ATHARM4/SpO2-Project/Presentation.pdf

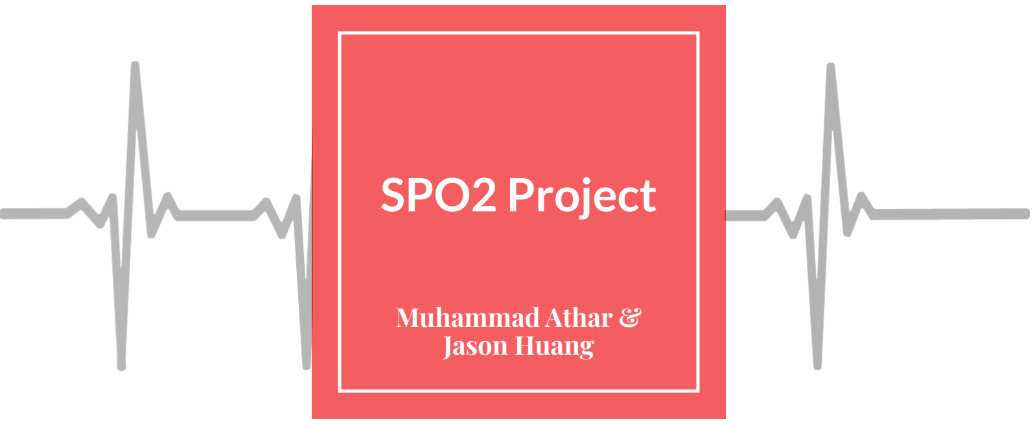
[picture p18: page 1]

## SPO2 Project

Muhammad Athar &
Jason Huang

## Brief Overview

❏ Requirements and Constraints ❏ High Level Model
❏ Individual Subcircuits
❏ Arduino
❏ Validation

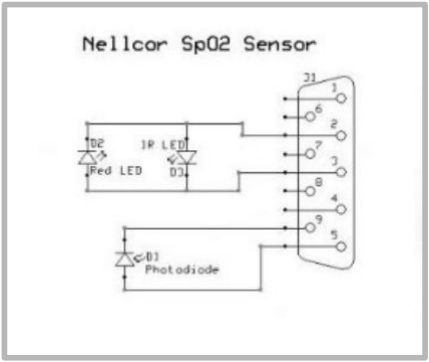
[picture p19: figure]

SpO2 Sensor Pinout

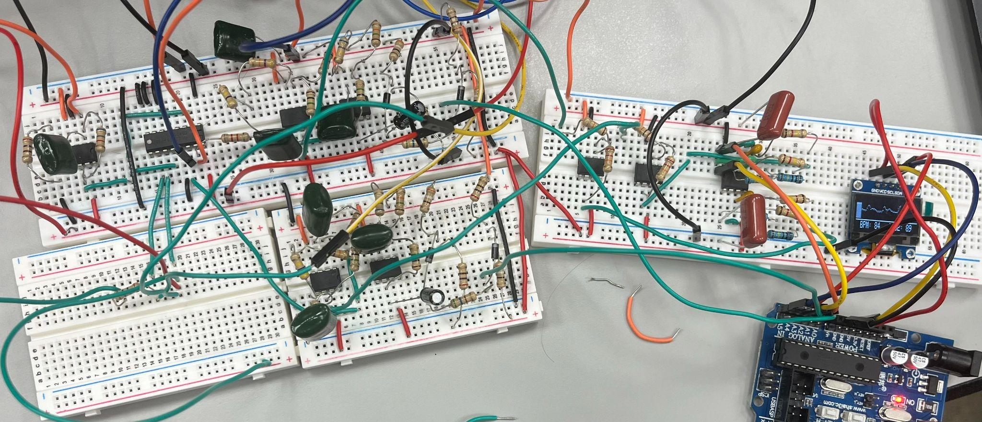
[picture p20: figure]

Final Working Product

## Design Requirements & Constraints

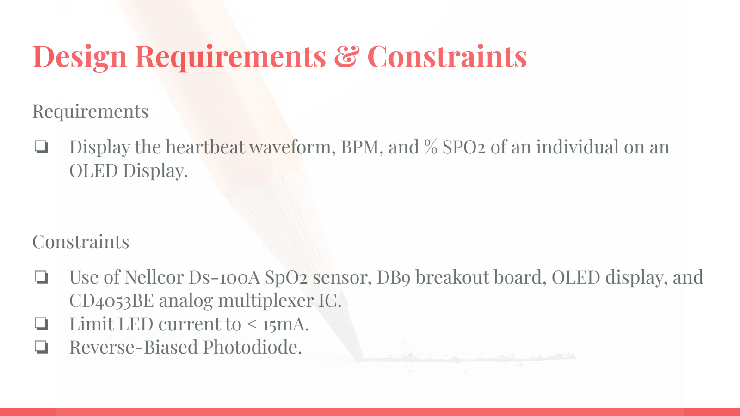
[picture p21: page 3]

Requirements
❏ Display the heartbeat waveform, BPM, and % SPO2 of an individual on an OLED Display.

Constraints
❏ Use of Nellcor Ds-100A SpO2 sensor, DB9 breakout board, OLED display, and CD4053BE analog multiplexer IC.
❏ Limit LED current to < 15mA.
❏ Reverse-Biased Photodiode.

## High Level Model

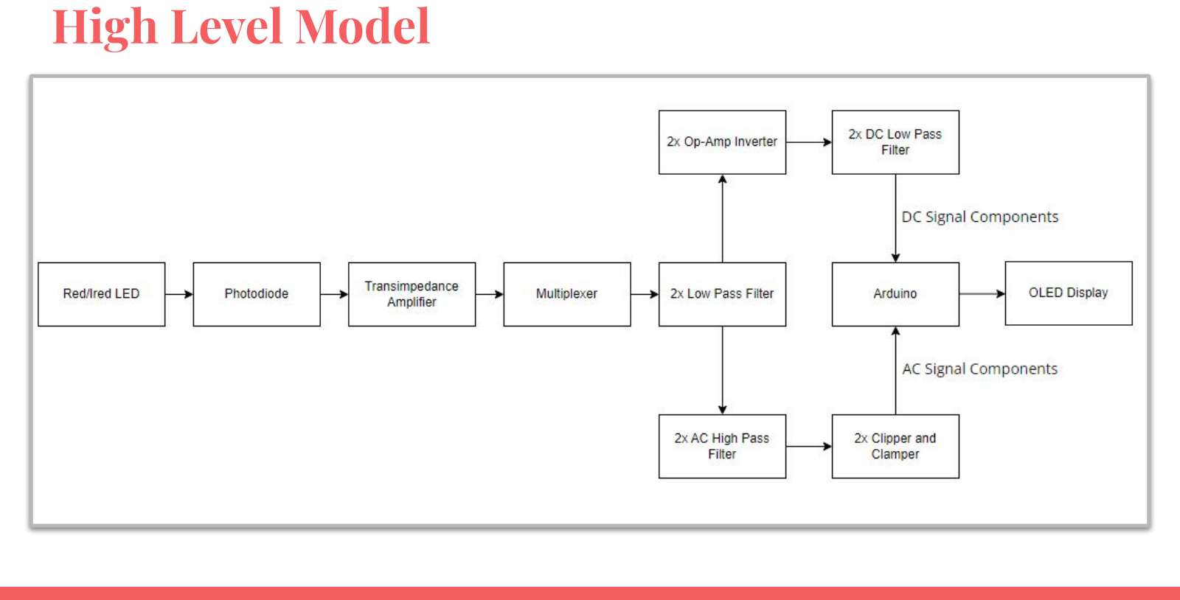
[picture p22: page 4]

## Transimpedance Amplifier

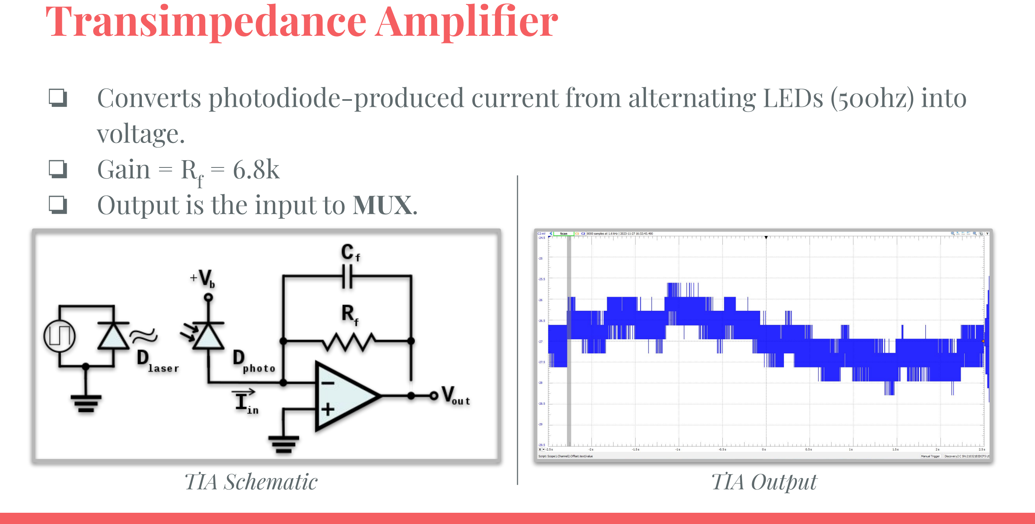
[picture p23: page 5]

❏ Converts photodiode-produced current from alternating LEDs (500hz) into voltage.
❏ Gain = Rf

= 6.8k
❏ Output is the input to MUX.
TIA Schematic | TIA Output

## Multiplexer

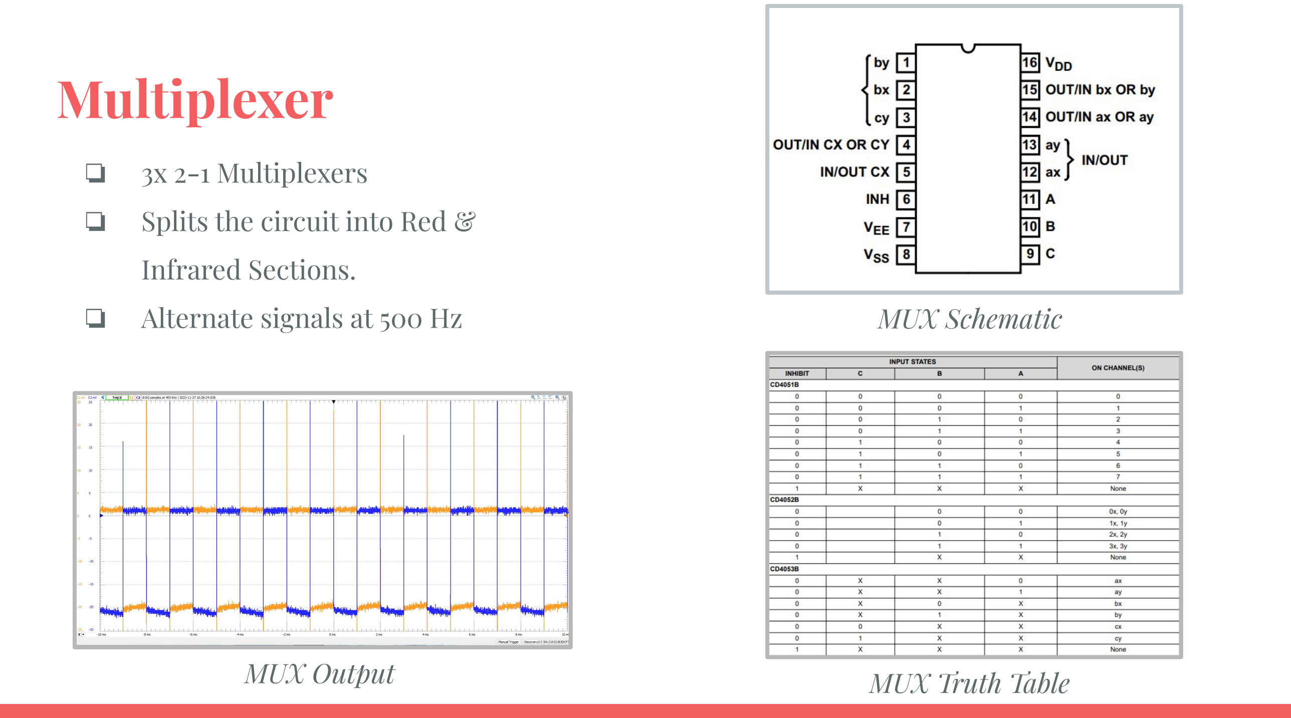
[picture p24: page 6]

❏ | 3x 2-1 Multiplexers
❏ | Splits the circuit into Red &
| Infrared Sections.
❏ | Alternate signals at 500 Hz | MUX Schematic
MUX Output | MUX Truth Table

## AC Filtration Circuit

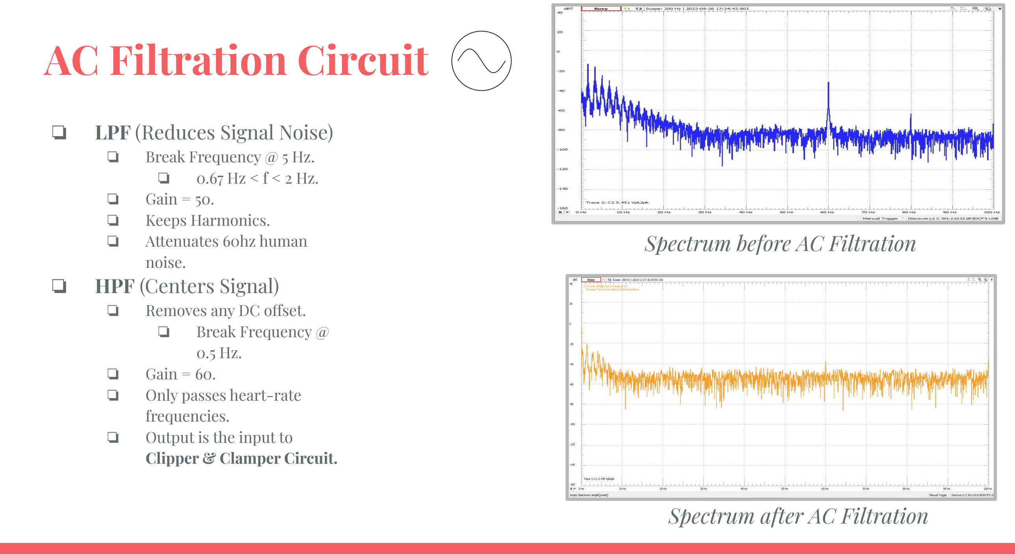
[picture p25: page 7]

❏ | LPF (Reduces Signal Noise)
❏ | Break Frequency @ 5 Hz.
❏ | 0.67 Hz < f < 2 Hz.
❏ | Gain = 50.
❏ | Keeps Harmonics.
❏ | Attenuates 60hz human
noise.
❏ | HPF (Centers Signal)
❏ | Removes any DC offset.
❏ | Break Frequency @
0.5 Hz.
❏ | Gain = 60.
❏ | Only passes heart-rate
frequencies.
❏ Output is the input to
Clipper & Clamper Circuit.

Spectrum after AC Filtration

Spectrum before AC Filtration

## Clipper & Clamper

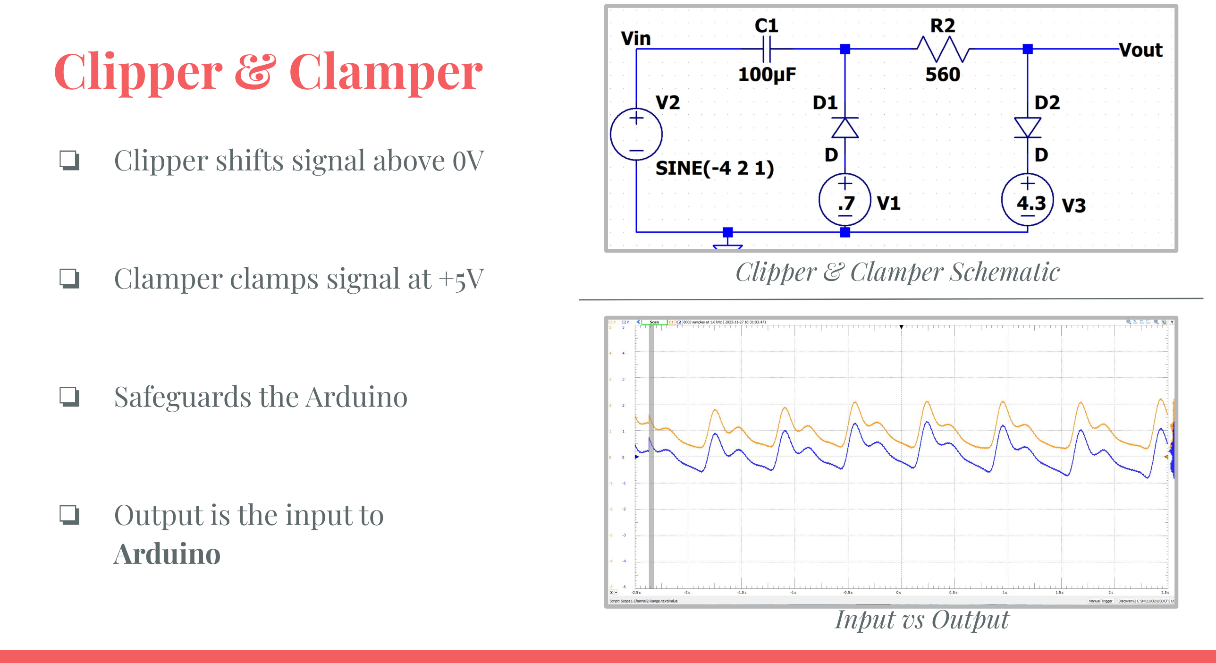
[picture p26: page 8]

❏ Clipper shifts signal above 0V

❏ Clamper clamps signal at +5V

❏ Safeguards the Arduino

❏ Output is the input to
Arduino

Clipper & Clamper Schematic

Input vs Output

## DC Circuit

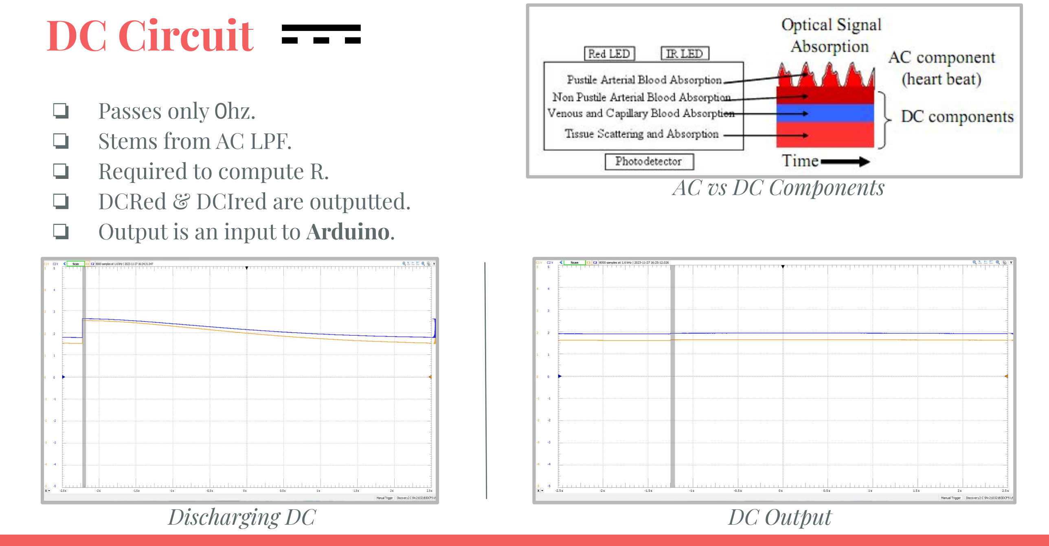
[picture p27: page 9]

❏ | Passes only 0hz.
❏ | Stems from AC LPF.
❏ | Required to compute R.
❏ | DCRed & DCIred are outputted.
❏ | Output is an input to Arduino.
Discharging DC | DC Output

AC vs DC Components

## Arduino

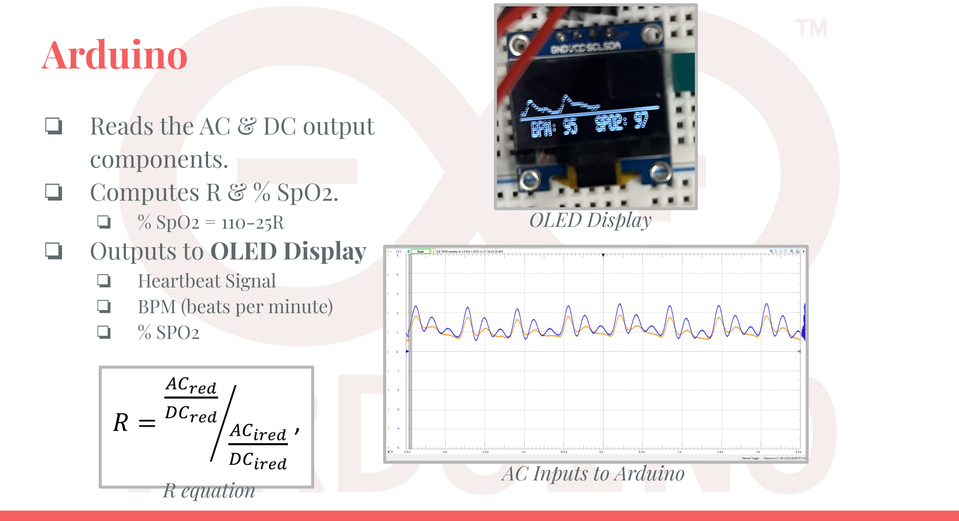
[picture p28: page 10]

❏ Reads the AC & DC output components.
❏ Computes R & % SpO2.
❏ % SpO2 = 110-25R
❏ Outputs to OLED Display
❏ | Heartbeat Signal
❏ | BPM (beats per minute)
❏ | % SPO2

OLED Display

AC Inputs to Arduino
R equation

## Validation Tests

❏ Comparisons between
Nellcor Ds-100A and
Commercial SpO2.
❏ BPM and waveform are
consistent.
❏ SpO2 value is close, with minimal margins of error.
❏ 80-100%
❏ Overall, it fulfilled the requirements under the
given constraints!

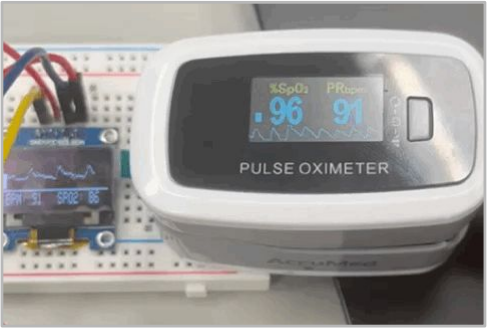
[picture p29: figure]

Nellcor vs Commercial Sensor

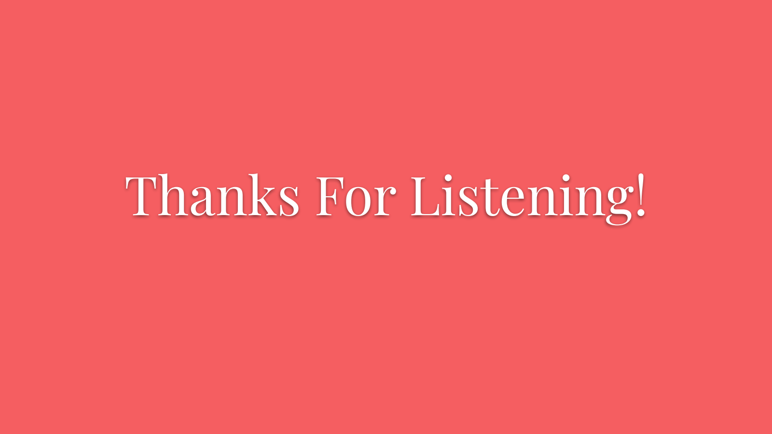
[picture p30: page 12]

# Thanks For Listening!
